zadockmaloba/OpenBoardLink/snapshots/REV-1-v0.1.png

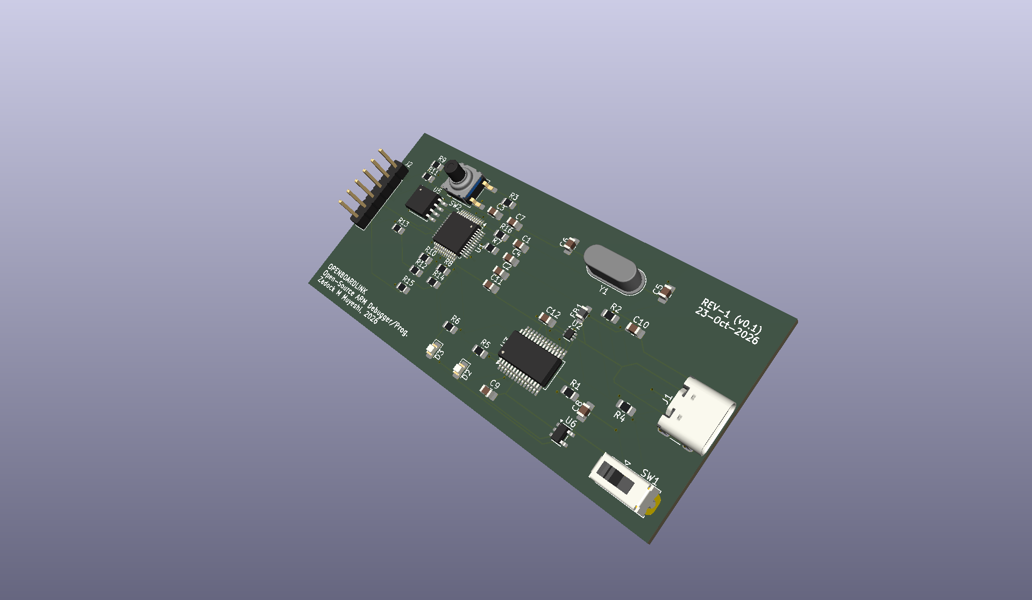
snapshots/REV-1-v0.1.png
