zadockmaloba/OpenBoardLink/snapshots/REV-1-v0.2.png

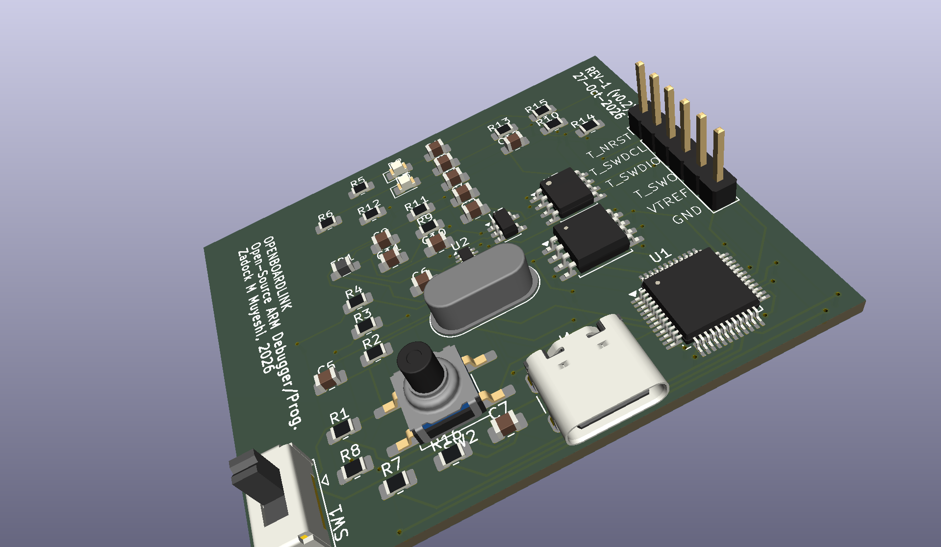
snapshots/REV-1-v0.2.png
