zadockmaloba/OpenBoardLink/snapshots/REV-1-v0.3.png

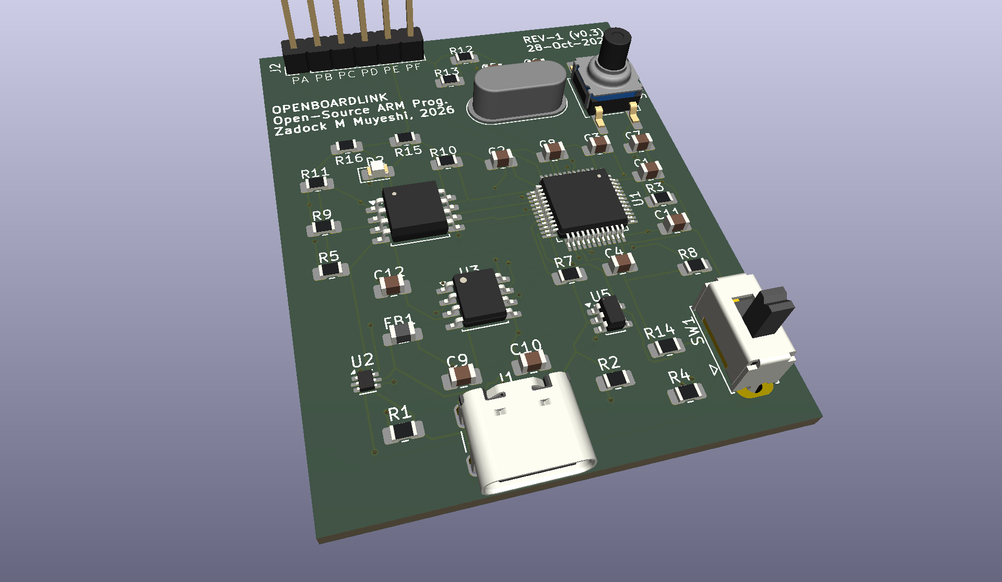
snapshots/REV-1-v0.3.png
