zadockmaloba/OpenBoardLink/hardware/production/bom.csv

Designator | Footprint | Quantity | Value | LCSC Part #
C1, C12, C2, C3, C4, C7 | 0805 | 6 | 100nF | C28233
C10, C11, C9 | 0805 | 3 | 10nF | C1710
C5, C6 | 0805 | 2 | 22pF | C1804
D2, D3 | 0805 | 2 | Yellow | C2296
FB1 | 0805 | 1 | 100R | C1015
R1, R2 | 0805 | 2 | 5k1 | C27834
R12 | 0805 | 1 | 47R | C17714
R13, R14, R5, R6 | 0805 | 4 | 1k | C17513
R3, R4, R7 | 0805 | 3 | 10k | C17414
R8 | 0805 | 1 | 330R | C17630
U1 | LQFP-48_7x7mm_P0.5mm | 1 | STM32F103C8Tx | C8734
U2 | SOT-23-6 | 1 | USBLC6-2SC6 | C6807798
U3 | JEITA_SOIC-8_3.9x4.9mm_P1.27mm | 1 | CH340N | C2977777
U5 | SOT-23-5 | 1 | AP2112K-3.3 | C3021085
Y1 | Crystal_HC49-4H_Vertical | 1 | Crystal | C326536
