zadockmaloba/OpenBoardLink/hardware/USB2SWD.kicad_pcb

## KiCad design hardware/USB2SWD.kicad_pcb (2026-11-04)

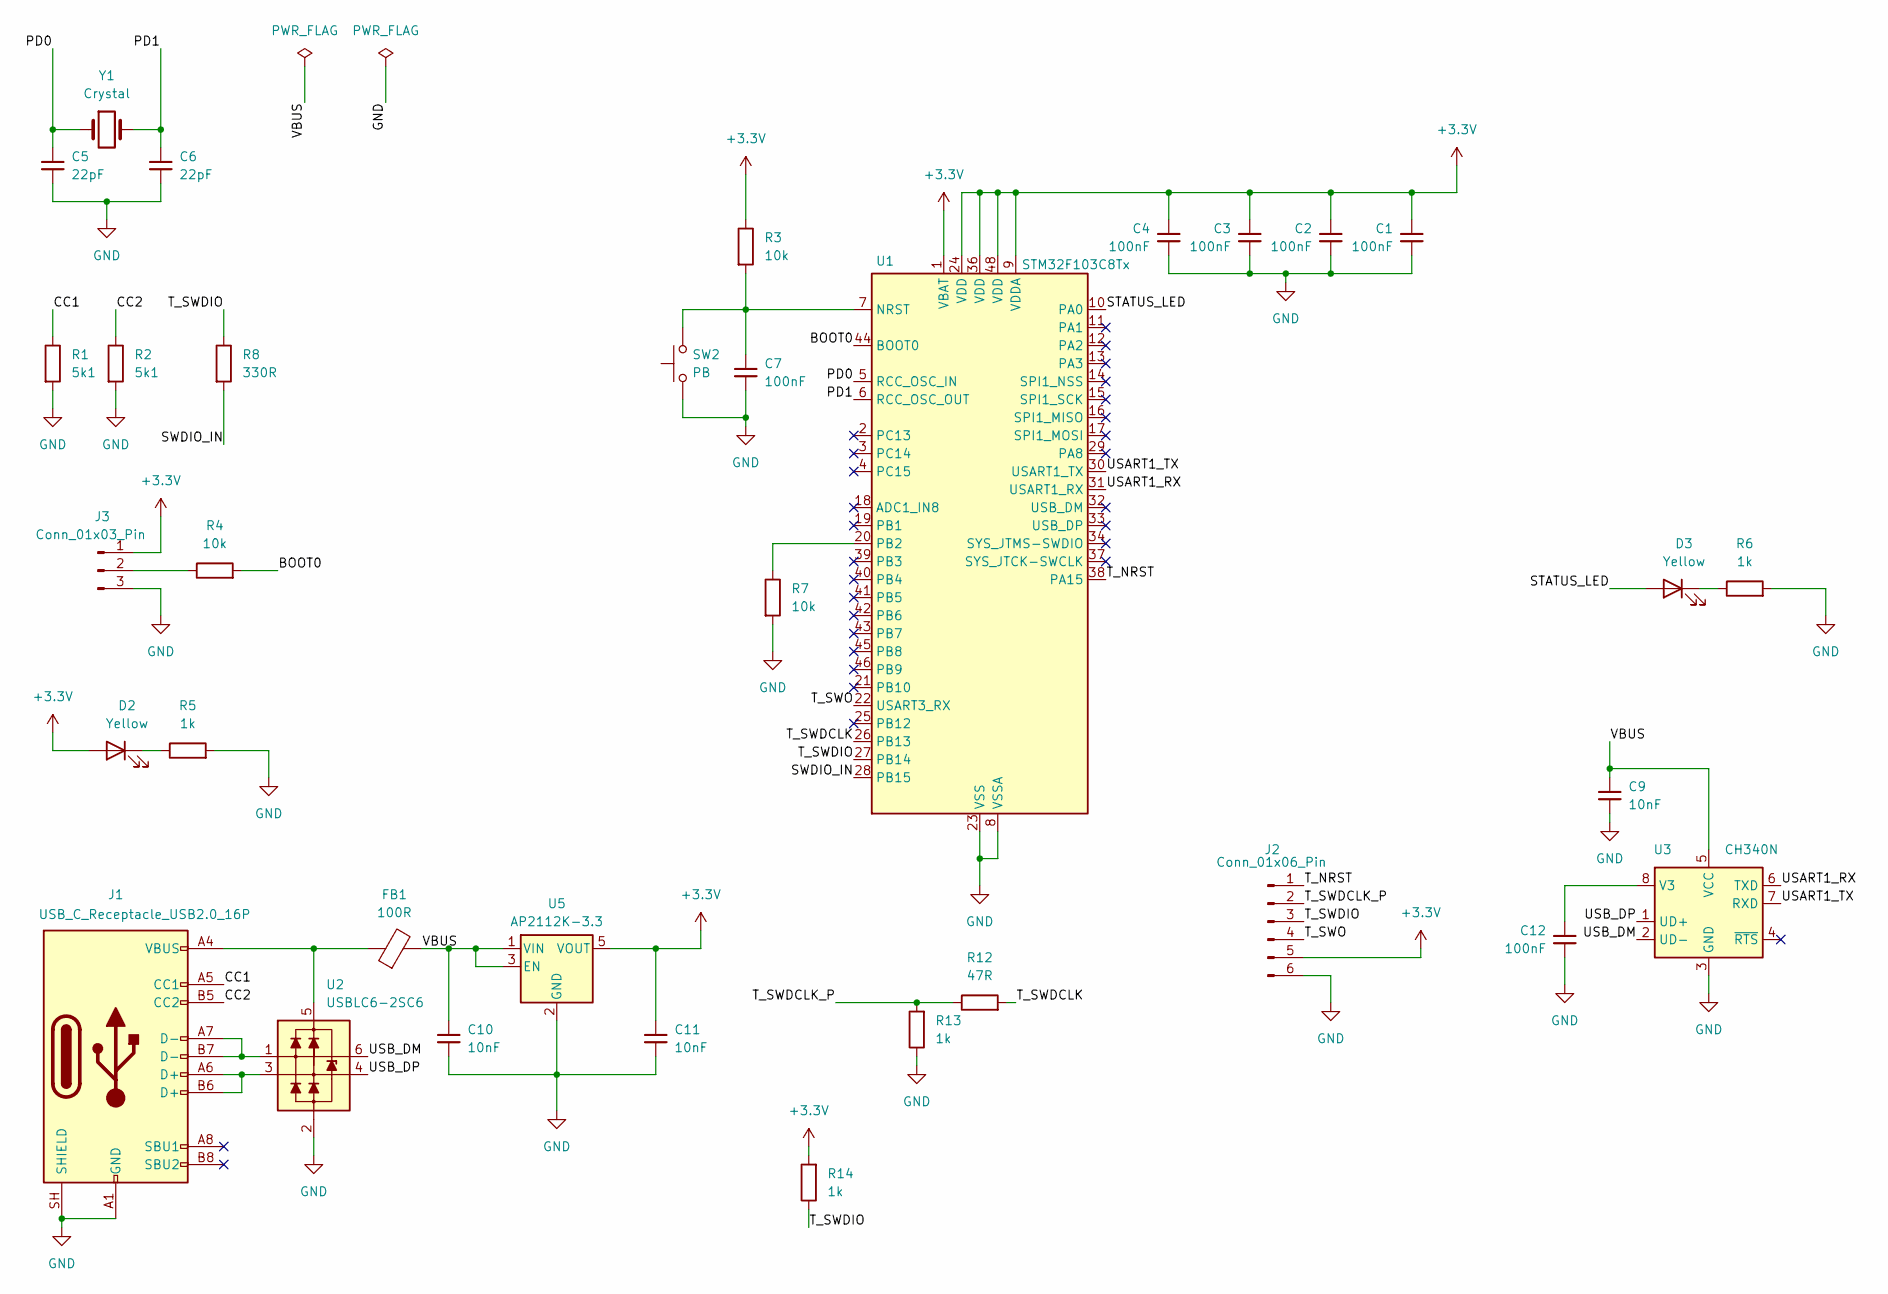
[picture p6: schematic USB2SWD.kicad_sch, OpenBoardLink (USB2SWD)]

Parts:
C1, C2, C3, C4, C7, C12: 100nF; C_0805_2012Metric_Pad1.18x1.45mm_HandSolder; LCSC C28233
C5, C6: 22pF; C_0805_2012Metric_Pad1.18x1.45mm_HandSolder; LCSC C1804
C9, C10, C11: 10nF; C_0805_2012Metric_Pad1.18x1.45mm_HandSolder; LCSC C1710
D2, D3: Yellow; LED_0805_2012Metric_Pad1.15x1.40mm_HandSolder; LCSC C2296
FB1: 100R; L_0805_2012Metric_Pad1.05x1.20mm_HandSolder; LCSC C1015
J1: USB_C_Receptacle_USB2.0_16P; USB_C_Receptacle_GCT_USB4105-xx-A_16P_TopMnt_Horizontal; LCSC C27636760
J2: Conn_01x06_Pin; PinHeader_1x06_P2.54mm_Vertical; LCSC C32713272
J3: Conn_01x03_Pin; PinHeader_1x03_P2.54mm_Vertical
R1, R2: 5k1; R_0805_2012Metric_Pad1.20x1.40mm_HandSolder; LCSC C27834
R3, R4, R7: 10k; R_0805_2012Metric_Pad1.20x1.40mm_HandSolder; LCSC C17414
R5, R6, R13, R14: 1k; R_0805_2012Metric_Pad1.20x1.40mm_HandSolder; LCSC C17513
R8: 330R; R_0805_2012Metric_Pad1.20x1.40mm_HandSolder; LCSC C17630
R12: 47R; R_0805_2012Metric_Pad1.20x1.40mm_HandSolder; LCSC C17714
SW2: PB; SW_Push_1P1T_NO_CK_KMR2; LCSC C556652
U1: STM32F103C8Tx; LQFP-48_7x7mm_P0.5mm; LCSC C8734
U2: USBLC6-2SC6; SOT-23-6; LCSC C6807798
U3: CH340N; JEITA_SOIC-8_3.9x4.9mm_P1.27mm; LCSC C2977777
U5: AP2112K-3.3; SOT-23-5; LCSC C3021085
Y1: Crystal; Crystal_HC49-4H_Vertical; LCSC C326536

Connections:
+3.3V: C1.1, C2.1, C3.1, C4.1, C11.1, D2.2 (A), J2.5, J3.1, R3.1, R14.2, U1.1 (VBAT), U1.9 (VDDA), U1.24 (VDD), U1.36 (VDD), U1.48 (VDD), U5.5 (VOUT)
/BOOT0: R4.2, U1.44 (BOOT0)
/CC1: J1.A5 (CC1), R1.1
/CC2: J1.B5 (CC2), R2.1
/PD0: C5.1, U1.5 (RCC_OSC_IN), Y1.1
/PD1: C6.1, U1.6 (RCC_OSC_OUT), Y1.2
/STATUS_LED: D3.2 (A), U1.10 (PA0)
/SWDIO_IN: R8.2, U1.28 (PB15)
/T_NRST: J2.1, U1.38 (PA15)
/T_SWDCLK: R12.2, U1.26 (PB13)
/T_SWDCLK_P: J2.2, R12.1, R13.2
/T_SWDIO: J2.3, R8.1, R14.1, U1.27 (PB14)
/T_SWO: J2.4, U1.22 (USART3_RX)
/USART1_RX: U1.31 (USART1_RX), U3.6 (TXD)
/USART1_TX: U1.30 (USART1_TX), U3.7 (RXD)
/USB_DM: U2.6 (L1), U3.2 (UD-)
/USB_DP: U2.4 (L2), U3.1 (UD+)
/VBUS: C9.1, C10.1, FB1.2, U3.5 (VCC), U5.1 (VIN), U5.3 (EN)
GND: C1.2, C2.2, C3.2, C4.2, C5.2, C6.2, C7.2, C9.2, C10.2, C11.2, C12.2, J1.A1 (GND), J1.A12 (GND), J1.B1 (GND), J1.B12 (GND), J1.SH (SHIELD), J2.6, J3.3, R1.2, R2.2, R5.2, R6.2, R7.2, R13.1, SW2.1, U1.8 (VSSA), U1.23 (VSS), U1.35 (VSS), U1.47 (VSS), U2.2 (VN), U3.3 (GND), U5.2 (GND)
unnamed: D2.1 (K), R5.1
unnamed: D3.1 (K), R6.1
unnamed: J1.A6 (D+), J1.B6 (D+), U2.3 (L2)
unnamed: J1.A7 (D-), J1.B7 (D-), U2.1 (L1)
unnamed: J3.2, R4.1
unnamed: C7.1, R3.2, SW2.2, U1.7 (NRST)
unnamed: R7.1, U1.20 (PB2)
unnamed: FB1.1, J1.A4 (VBUS), J1.A9 (VBUS), J1.B4 (VBUS), J1.B9 (VBUS), U2.5 (VP)
unnamed: C12.1, U3.8 (V3)

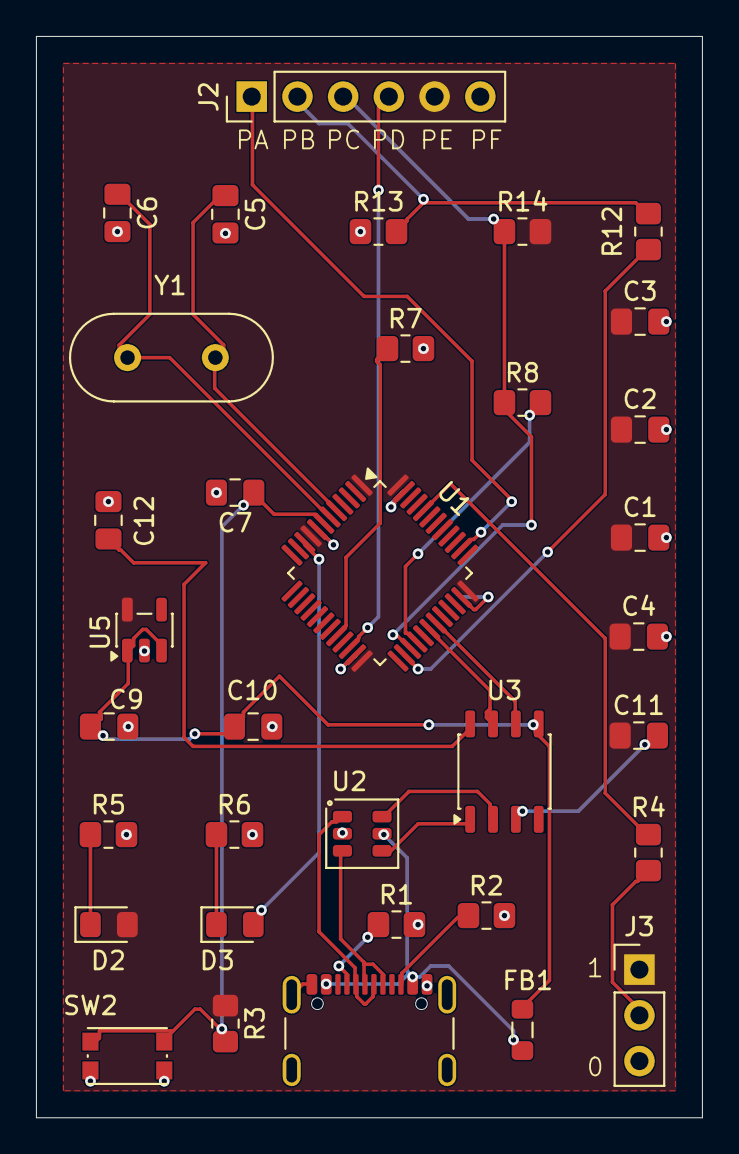
[picture p7: board USB2SWD.kicad_pcb from above]

Board: 2 copper layers, 37.0 x 60.1 mm, 34 parts (0 on the bottom side), 28 nets.
