zadockmaloba/OpenBoardLink/(commit log)

2026-10-18 Add 32MB Flash and LDO
    [USB2SWD.kicad_sch]
2026-10-20 Fix all ERC errors
    [USB2SWD.kicad_sch]
2026-10-27 Rev-1 v0.1
    [USB2SWD-B_Cu.gbr, USB2SWD-B_Mask.gbr, USB2SWD-B_Paste.gbr, USB2SWD-B_Silkscreen.gbr, USB2SWD-Edge_Cuts.gbr, USB2SWD-F_Cu.gbr, USB2SWD-F_Mask.gbr, USB2SWD-F_Paste.gbr]
2026-10-28 Rev-1 v0.2
    [USB2SWD-B_Cu.gbr, USB2SWD-B_Mask.gbr, USB2SWD-B_Paste.gbr, USB2SWD-B_Silkscreen.gbr, USB2SWD-Edge_Cuts.gbr, USB2SWD-F_Cu.gbr, USB2SWD-F_Mask.gbr, USB2SWD-F_Paste.gbr]
2026-10-29 Rev-1 v0.3
    [USB2SWD.csv, USB2SWD.kicad_pcb, USB2SWD.kicad_sch]
2026-10-31 Setup custom board dts and firmware
2026-10-31 Enable UART console
2026-11-01 Board Update: v1.0.4
    Add status led to indicate FW execution status
    Add power and ground planes
    Fix all DRC errors
    [USB2SWD.kicad_pcb, USB2SWD.kicad_sch]
2026-11-01 Reorganise hardware folder
    [USB2SWD-B_Cu.gbr, USB2SWD-B_Mask.gbr, USB2SWD-B_Paste.gbr, USB2SWD-B_Silkscreen.gbr, USB2SWD-Edge_Cuts.gbr, USB2SWD-F_Cu.gbr, USB2SWD-F_Mask.gbr, USB2SWD-F_Paste.gbr]
2026-11-02 Update BOM
    [USB2SWD.kicad_pcb, USB2SWD.kicad_sch, bom.csv]
2026-11-02 Update BOM with more LCSC Basic SMT components
    [USB2SWD.kicad_pcb, USB2SWD.kicad_sch, bom.csv]
2026-11-04 Rev 1.0.5
    [USB2SWD.kicad_pcb, USB2SWD.kicad_sch, bom.csv, designators.csv, positions.csv]
2026-11-04 WIP: Initial works on an openOCD script
    [stm32_ftdi.cfg]
2026-11-06 Implement ASYNC DMA UART
2026-11-08 Switch to GPLv3
    Updated copyright holder and year in the LICENSE file.
2026-11-08 WIP: Begin implementation of the SWD driver
